W9KSB/W9KSB-Rotctld-Serial-Bridge/STLs/Main Housing.stl

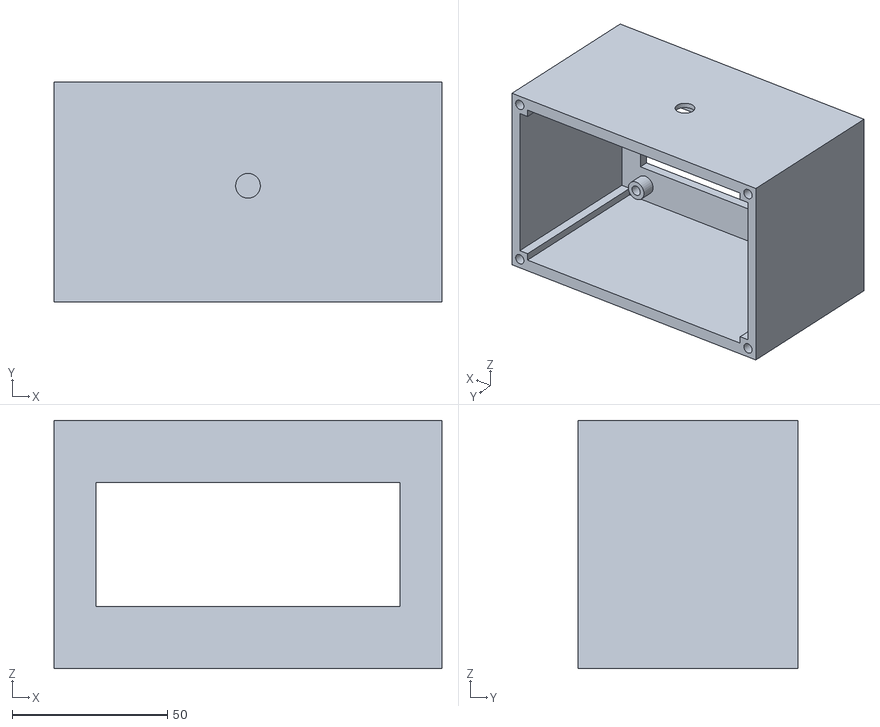
[picture p5: CAD file, 2026-02-27]
STLs/Main Housing.stl
125.0 x 71.0 x 80.0
