W9KSB/W9KSB-Rotctld-Serial-Bridge/STLs/Backside Lid.stl

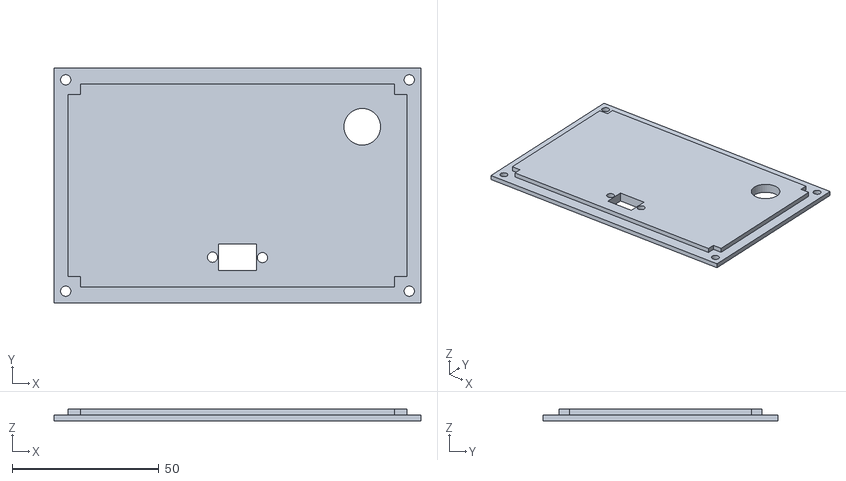
[picture p6: CAD file, 2026-02-27]
STLs/Backside Lid.stl
125.0 x 80.0 x 4.00
