W9KSB/W9KSB-Rotctld-Serial-Bridge/photos/GUI-3-Debug.jpg

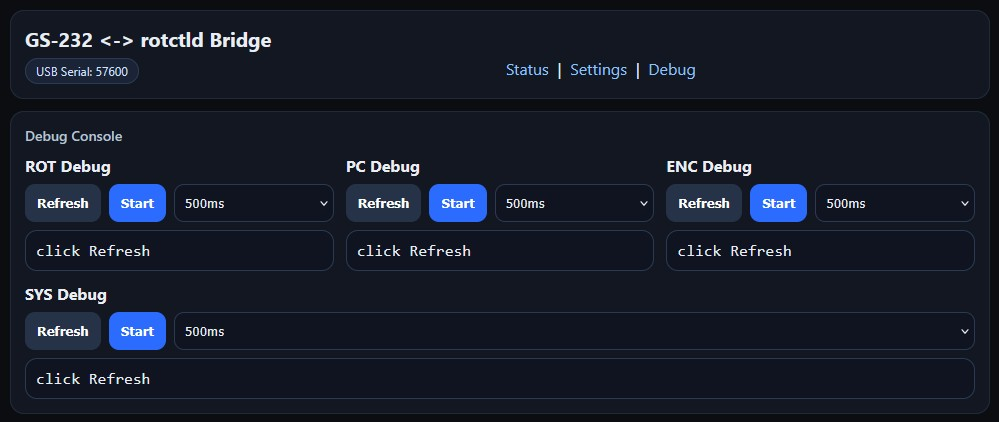
photos/GUI-3-Debug.jpg
