W9KSB/W9KSB-Rotctld-Serial-Bridge/(commit log)

2026-02-27 Update controller.ino
    Wifi Settings now able to be configured directly from the settings page. No need to change the code before uploading to ESP32. Device will boot to AP mode the first time where a user can connect directly and then add their wifi settings there.
2026-02-27 Rename Backside Lid.stl to STLs/Backside Lid.stl
    [Backside Lid.stl]
2026-02-27 Rename Main Housing.stl to STLs/Main Housing.stl
    [Main Housing.stl]
2026-03-13 Delete code directory
    Moving project from ESP32 to a Pi Zero
