W9KSB/W9KSB-Rotctld-Serial-Bridge/(notices)

Notices in the files:
README.md:
License: Hobby Use
